Surgical-Lighting-MIT-2-75-2024/SurgicalLightBoostConverterModule/Rev A/SurgicalLightBoostConverterModuleBOM.xlsx

Id | Designator | Footprint | Quantity | Designation | Supplier and ref
1 | R15,R24,R19 | R_0805_2012Metric | 3 | 100K | RMCF0805FT100KCT-ND
2 | R16,R21,R3,R13,R12,R23 | R_0805_2012Metric | 6 | 1K | RMCF0805FT1K00CT-ND
3 | R9,R22,R25,R20,R10,R14 | R_0805_2012Metric | 6 | 10K | RMCF0805FT10K0CT-ND
4 | U1 | DIP-16_W7.62mm | 1 | TL494 | 296-10194-5-ND
5 | Q1,Q2,Q3 | TO-92_Inline | 3 | BC337 | BC337-25-APMSCT-ND
6 | TP6 | TestPoint_Loop_D2.54mm_Drill1.5mm_Beaded | 1 | 5V | 36-5260-ND
7 | R4,R5,R6 | R_0805_2012Metric | 3 | 10 | RMCF0805FT10R0CT-ND
8 | R8,R2 | R_0805_2012Metric | 2 | 2K | RNCP0805FTD2K00CT-ND
9 | C1,C2 | CP_Radial_D12.5mm_P5.00mm | 2 | 470uF | 1189-2329-ND
10 | TP13 | TestPoint_Loop_D2.54mm_Drill1.5mm_Beaded | 1 | CS- | 36-5264-ND
11 | C12,C7,C5,C6,C8,C10,C15,C9 | C_0805_2012Metric | 8 | 0.1uF | 1276-1003-1-ND
12 | R7 | R_0805_2012Metric | 1 | 330 | RMCF0805FT330RCT-ND
13 | C13 | C_0805_2012Metric | 1 | 1nF | 1276-1091-1-ND
14 | Q9,Q10,Q7,Q8 | TO-92_Inline | 4 | BC327 | BC32725BUFS-ND
15 | D3,D7,D4 | LED_0805_2012Metric | 3 | LED Green | 732-4983-1-ND
16 | J1 | PinHeader_2x07_P2.54mm_Vertical | 1 | 2x7 P2.54mm | 2057-PH2-14-UA-ND
17 | C11,C14 | C_0805_2012Metric | 2 | 1uF | 1276-1029-1-ND
18 | D5,D9,D2,D1,D6 | Nexperia_CFP15_SOT-1289 | 5 | PMEG045V150EPD | 1727-7635-1-ND
19 | L1 | L_Radial_D29.8mm_P29.30mm_Murata_1400series | 1 | 68uH 11.4A | M8376-ND
20 | Q4,Q5,Q6 | TO-220-3_Vertical | 3 | IRLZ44N | IRLZ44NPBF | or IRFZ44NPBF idk whatever ur getting dude
21 | TP1 | TestPoint_Loop_D2.54mm_Drill1.5mm_Beaded | 1 | LMount1 | N/A
22 | R17 | R_0805_2012Metric | 1 | 2K2 | RMCF0805FT2K20CT-ND
23 | U2 | DIP-8_W7.62mm_Socket | 1 | TL431D | 296-10182-5-ND
24 | TP12 | TestPoint_Loop_D2.54mm_Drill1.5mm_Beaded | 1 | 2IN- | 36-5269-ND
25 | TP8 | TestPoint_Loop_D2.54mm_Drill1.5mm_Beaded | 1 | 1IN+ | 36-5269-ND
26 | TP3 | TestPoint_Loop_D2.54mm_Drill1.5mm_Beaded | 1 | LMount4 | N/A
27 | C4,C3 | CP_Radial_D10.0mm_P5.00mm | 2 | 220uF | 1189-1759-ND
28 | TP2 | TestPoint_Loop_D2.54mm_Drill1.5mm_Beaded | 1 | LMount2 | N/A
29 | TP4 | TestPoint_Loop_D2.54mm_Drill1.5mm_Beaded | 1 | LMount3 | N/A
30 | D8 | LED_0805_2012Metric | 1 | LED Red | 732-4984-1-ND
31 | R11 | R_0805_2012Metric | 1 | 9.1K | 738-RMCF0805FT9K10CT-ND
32 | F1 | Fuseholder_Clip-6.3x32mm_Littelfuse_102071_Inline_P34.70x7.60mm_D2.00mm_Horizontal | 1 | 12A | 507-2231-ND
33 | R1 | R_2512_6332Metric | 1 | 5mR | CRF2512-FZ-R005ELFCT-ND
34 | TP5 | TestPoint_Loop_D2.54mm_Drill1.5mm_Beaded | 1 | 24V | 36-5260-ND
35 | TP10 | TestPoint_Loop_D2.54mm_Drill1.5mm_Beaded | 1 | DTC | 36-5269-ND
36 | TP7 | TestPoint_Loop_D2.54mm_Drill1.5mm_Beaded | 1 | 1IN- | 36-5269-ND
37 | TP11 | TestPoint_Loop_D2.54mm_Drill1.5mm_Beaded | 1 | CS+ | 36-5264-ND
38 | TP14 | TestPoint_Loop_D2.54mm_Drill1.5mm_Beaded | 1 | 2IN+ | 36-5269-ND
39 | U3 | DIP-8_W7.62mm_Socket | 1 | LM358 | 296-1395-5-ND
40 | TP9 | TestPoint_Loop_D2.54mm_Drill1.5mm_Beaded | 1 | PWM | 36-5269-ND
41 | R18 | R_0805_2012Metric | 1 | 3K9 | RMCF0805FT3K90CT-ND
42 | RV2,RV1 | PinHeader_1x03_P2.54mm_Vertical | 2 | 10K | 118-PV36W103C01B00-ND
