Surgical-Lighting-MIT-2-75-2024/SurgicalLightBoostConverterModule/Rev B/SurgicalLightBoostConverterModule.kicad_pcb

## KiCad design Rev B/SurgicalLightBoostConverterModule.kicad_pcb (2024-04-26)

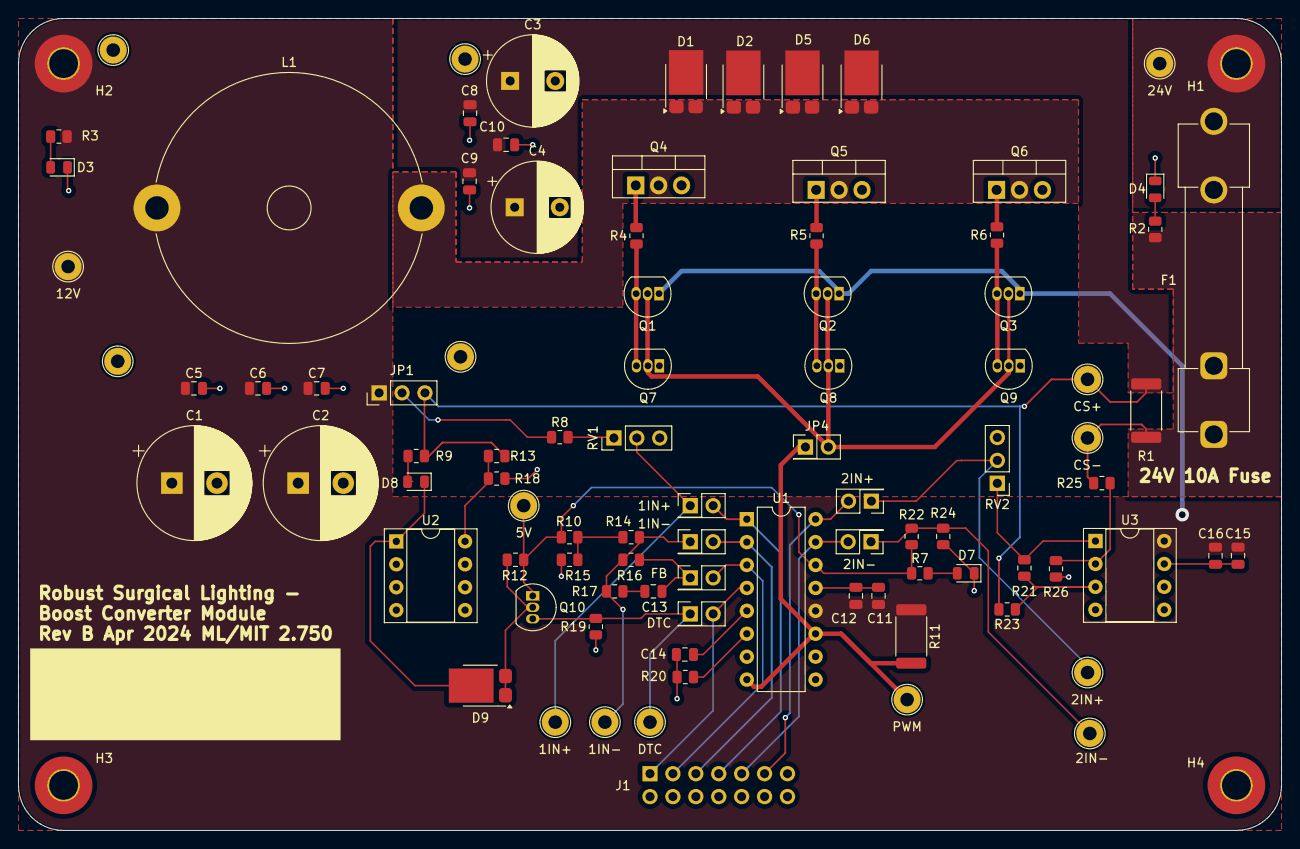
[picture p1: board Rev B/SurgicalLightBoostConverterModule.kicad_pcb from above]

Board: 2 copper layers, 140.0 x 90.0 mm, 96 parts (1 on the bottom side), 43 nets.

Parts:
1IN+: 1IN+; TestPoint_Loop_D2.54mm_Drill1.5mm_Beaded
1IN+#2: JMPR_1IN+; PinHeader_2x01_P2.54mm_Vertical
1IN-: 1IN-; TestPoint_Loop_D2.54mm_Drill1.5mm_Beaded
1IN-#2: JMPR_1IN-; PinHeader_2x01_P2.54mm_Vertical
2IN+: JMPR_2IN+; PinHeader_2x01_P2.54mm_Vertical
2IN+#2: 2IN+; TestPoint_Loop_D2.54mm_Drill1.5mm_Beaded
2IN-: 2IN-; TestPoint_Loop_D2.54mm_Drill1.5mm_Beaded
2IN-#2: JMPR_2IN-; PinHeader_2x01_P2.54mm_Vertical
5V: 5V; TestPoint_Loop_D2.54mm_Drill1.5mm_Beaded
12V: +12V; TestPoint_Loop_D2.54mm_Drill1.5mm_Beaded
24V: 24V; TestPoint_Loop_D2.54mm_Drill1.5mm_Beaded
C1, C2: 470uF; CP_Radial_D12.5mm_P5.00mm
C3, C4: 220uF; CP_Radial_D10.0mm_P5.00mm
C5, C6, C7, C8, C9, C10, C12, C13, C16: 0.1uF; C_0805_2012Metric
C11, C15: 1uF; C_0805_2012Metric
C14: 1nF; C_0805_2012Metric
CS+: CS+; TestPoint_Loop_D2.54mm_Drill1.5mm_Beaded
CS-: CS-; TestPoint_Loop_D2.54mm_Drill1.5mm_Beaded
D1, D2, D5, D6, D9: PMEG045V150EPD; Nexperia_CFP15_SOT-1289
D3, D4, D7: LED Green; LED_0805_2012Metric
D8: LED Red; LED_0805_2012Metric
DTC: JMPR_DTC; PinHeader_2x01_P2.54mm_Vertical
DTC#2: DTC; TestPoint_Loop_D2.54mm_Drill1.5mm_Beaded
F1: 12A; Fuseholder_Clip-6.3x32mm_Littelfuse_102071_Inline_P34.70x7.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
FB: JMPR_FB; PinHeader_2x01_P2.54mm_Vertical
H1, H2, H3, H4: M3 Hole; MountingHole_3.2mm_M3_Pad_TopBottom
J1: 2x7 P2.54mm; PinHeader_2x07_P2.54mm_Vertical
JP1: JMPR_VFB; PinHeader_1x03_P2.54mm_Vertical
JP4: JMPR_PWM; PinHeader_2x01_P2.54mm_Vertical
L1: 68uH 11.4A; L_Radial_D29.8mm_P29.30mm_Murata_1400series
PWM: PWM; TestPoint_Loop_D2.54mm_Drill1.5mm_Beaded
Q1, Q2, Q3: BC337; TO-92_Inline
Q4, Q5, Q6: AOT240L; TO-220-3_Vertical
Q7, Q8, Q9, Q10: BC327; TO-92_Inline
R1: 5mR; R_2512_6332Metric
R2: 4K7; R_0805_2012Metric
R3, R19: 2K2; R_0805_2012Metric
R4, R5, R6: 10; R_0805_2012Metric
R7: 330; R_0805_2012Metric
R8: 38K; R_0805_2012Metric
R9: 3K3; R_0805_2012Metric
R10, R12, R15, R22, R24: 10K; R_0805_2012Metric
R11: 100; R_2512_6332Metric
R13: 9.1K; R_0805_2012Metric
R14, R18, R23, R25: 1K; R_0805_2012Metric
R16, R21, R26: 100K; R_0805_2012Metric
R17: 82K; R_0805_2012Metric
R20: 3K9; R_0805_2012Metric
RV1, RV2: 10K; PinHeader_1x03_P2.54mm_Vertical
TP1: LMount1; TestPoint_Loop_D2.54mm_Drill1.5mm_Beaded
TP2: LMount2; TestPoint_Loop_D2.54mm_Drill1.5mm_Beaded
TP3: LMount4; TestPoint_Loop_D2.54mm_Drill1.5mm_Beaded
TP4: LMount3; TestPoint_Loop_D2.54mm_Drill1.5mm_Beaded
U1: TL494; DIP-16_W7.62mm
U2: TL431D; DIP-8_W7.62mm_Socket
U3: LM358; DIP-8_W7.62mm_Socket

Connections:
+5V: 5V.1, Q10.1 (C), R7.1, R10.1, R12.1, R22.1, U1.14 (REF)
+12V: 12V.1, C1.1, C2.1, C5.1, C6.1, C7.1, C11.1, C12.1, C15.1, C16.1, H2.1, JP1.1 (A), L1.1, Q1.1 (C), Q2.1 (C), Q3.1 (C), R3.1, R11.1, U1.12 (VCC), U3.8 (V+)
+24V: 24V.1, F1.2, H1.1
/1IN+: 1IN+#2.2 (B), J1.7, U1.1 (1IN+)
/1IN-: 1IN-#2.2 (B), J1.5, U1.2 (1IN-)
/2IN+: 2IN+.2 (B), J1.11, U1.16 (2IN+)
/2IN-: 2IN-#2.2 (B), J1.9, U1.15 (2IN-)
/CS+: C3.1, C4.1, C8.1, C9.1, C10.1, CS+.1, D1.3 (K), D2.3 (K), D5.3 (K), D6.3 (K), JP1.3 (B), R1.1, R9.1, R13.1, R23.2
/CS-: CS-.1, F1.1, R1.2, R2.1, R25.1
/DTC: DTC.2 (B), J1.1, U1.4 (DTC)
/FB: FB.2 (B), J1.3, U1.3 (FB)
/VSwitch: D1.1 (A), D1.2 (A), D2.1 (A), D2.2 (A), D5.1 (A), D5.2 (A), D6.1 (A), D6.2 (A), L1.2, Q4.2 (D), Q5.2 (D), Q6.2 (D)
GND: C1.2, C2.2, C3.2, C4.2, C5.2, C6.2, C7.2, C8.2, C9.2, C10.2, C11.2, C12.2, C14.2, C15.2, C16.2, D3.1 (K), D4.1 (K), D7.1 (K), H3.1, H4.1, J1.14, Q4.3 (S), Q5.3 (S), Q6.3 (S), Q7.1 (C), Q8.1 (C), Q9.1 (C), R15.2, R18.2, R19.2, R20.2, R24.2, R26.1, RV1.3, RV2.3, U1.7 (GND), U1.9 (E1), U1.10 (E2), U1.13 (OUTCTRL), U2.2 (A), U2.3 (A), U2.6 (A), U2.7 (A), U3.4 (V-), U3.5 (+), U3.6 (-), U3.7
unnamed: C13.1, R17.2
unnamed: D3.2 (A), R3.2
unnamed: D4.2 (A), R2.2
unnamed: D7.2 (A), R7.2
unnamed: D8.2 (A), R9.2
unnamed: D8.1 (K), D9.3 (K), U2.1 (K)
unnamed: JP1.2 (C), R8.1
unnamed: 1IN+.1, 1IN+#2.1 (A), RV1.2
unnamed: 1IN-.1, 1IN-#2.1 (A), R14.2, R16.1, R17.1
unnamed: JP4.1 (A), PWM.1, R11.2, U1.8 (C1), U1.11 (C2)
unnamed: C13.2, FB.1 (A), R16.2
unnamed: DTC.1 (A), DTC#2.1, Q10.3 (E), R19.1
unnamed: 2IN-.1, 2IN-#2.1 (A), R22.2, R24.1
unnamed: 2IN+.1 (A), 2IN+#2.1, RV2.2
unnamed: Q1.3 (E), Q7.3 (E), R4.1
unnamed: Q2.3 (E), Q8.3 (E), R5.1
unnamed: Q3.3 (E), Q9.3 (E), R6.1
unnamed: Q4.1 (G), R4.2
unnamed: Q5.1 (G), R5.2
unnamed: Q6.1 (G), R6.2
unnamed: D9.1 (A), D9.2 (A), Q10.2 (B), R12.2
unnamed: R8.2, RV1.1
unnamed: R10.2, R14.1, R15.1
unnamed: R21.1, RV2.1, U3.1
unnamed: C14.1, U1.5 (CT)
unnamed: R20.1, U1.6 (RT)
unnamed: R13.2, R18.1, U2.8 (REF)
unnamed: R21.2, R23.1, U3.3 (+)
unnamed: R25.2, R26.2, U3.2 (-)
PWM: JP4.2 (B), Q1.2 (B), Q2.2 (B), Q3.2 (B), Q7.2 (B), Q8.2 (B), Q9.2 (B)
