Surgical-Lighting-MIT-2-75-2024/SurgicalLightBoostConverterModule/Rev A/SurgicalLightBoostConverterModule.kicad_pcb

## KiCad design Rev A/SurgicalLightBoostConverterModule.kicad_pcb (2024-04-05, an earlier design)

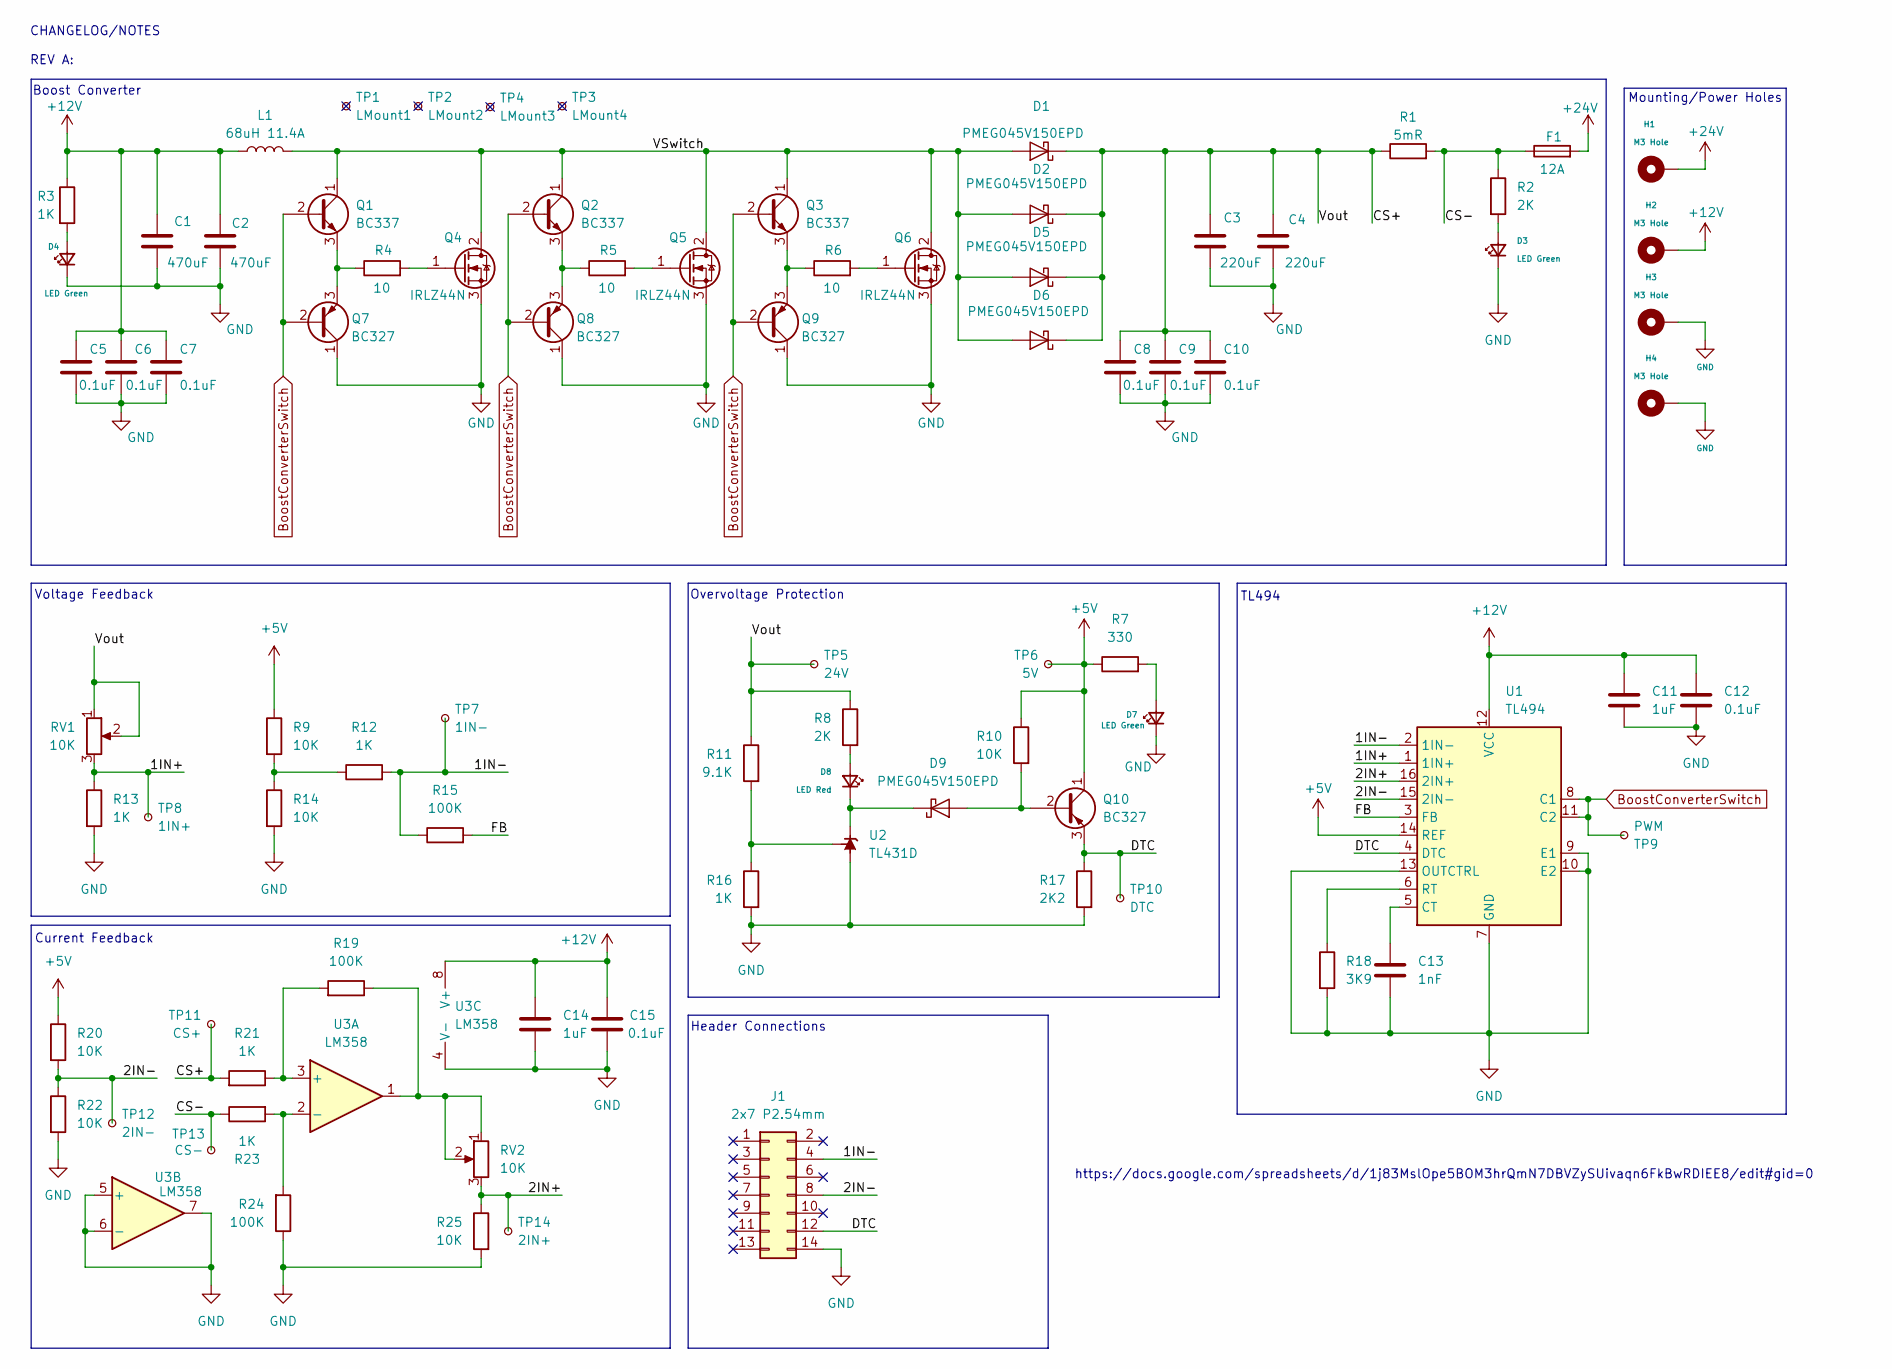
[picture p2: schematic SurgicalLightBoostConverterModule.kicad_sch, Main]

Parts:
C1, C2: 470uF; CP_Radial_D12.5mm_P5.00mm
C3, C4: 220uF; CP_Radial_D10.0mm_P5.00mm
C5, C6, C7, C8, C9, C10, C12, C15: 0.1uF; C_0805_2012Metric
C11, C14: 1uF; C_0805_2012Metric
C13: 1nF; C_0805_2012Metric
D1, D2, D5, D6, D9: PMEG045V150EPD; Nexperia_CFP15_SOT-1289
D3, D4, D7: LED Green; LED_0805_2012Metric
D8: LED Red; LED_0805_2012Metric
F1: 12A; Fuseholder_Clip-6.3x32mm_Littelfuse_102071_Inline_P34.70x7.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
H1, H2, H3, H4: M3 Hole; MountingHole_3.2mm_M3_Pad_TopBottom
J1: 2x7 P2.54mm; PinHeader_2x07_P2.54mm_Vertical
L1: 68uH 11.4A; L_Radial_D29.8mm_P29.30mm_Murata_1400series
Q1, Q2, Q3: BC337; TO-92_Inline
Q4, Q5, Q6: IRLZ44N; TO-220-3_Vertical
Q7, Q8, Q9, Q10: BC327; TO-92_Inline
R1: 5mR; R_2512_6332Metric
R2, R8: 2K; R_0805_2012Metric
R3, R12, R13, R16, R21, R23: 1K; R_0805_2012Metric
R4, R5, R6: 10; R_0805_2012Metric
R7: 330; R_0805_2012Metric
R9, R10, R14, R20, R22, R25: 10K; R_0805_2012Metric
R11: 9.1K; R_0805_2012Metric
R15, R19, R24: 100K; R_0805_2012Metric
R17: 2K2; R_0805_2012Metric
R18: 3K9; R_0805_2012Metric
RV1, RV2: 10K; PinHeader_1x03_P2.54mm_Vertical
TP1: LMount1; TestPoint_Loop_D2.54mm_Drill1.5mm_Beaded
TP2: LMount2; TestPoint_Loop_D2.54mm_Drill1.5mm_Beaded
TP3: LMount4; TestPoint_Loop_D2.54mm_Drill1.5mm_Beaded
TP4: LMount3; TestPoint_Loop_D2.54mm_Drill1.5mm_Beaded
TP5: 24V; TestPoint_Loop_D2.54mm_Drill1.5mm_Beaded
TP6: 5V; TestPoint_Loop_D2.54mm_Drill1.5mm_Beaded
TP7: 1IN-; TestPoint_Loop_D2.54mm_Drill1.5mm_Beaded
TP8: 1IN+; TestPoint_Loop_D2.54mm_Drill1.5mm_Beaded
TP9: PWM; TestPoint_Loop_D2.54mm_Drill1.5mm_Beaded
TP10: DTC; TestPoint_Loop_D2.54mm_Drill1.5mm_Beaded
TP11: CS+; TestPoint_Loop_D2.54mm_Drill1.5mm_Beaded
TP12: 2IN-; TestPoint_Loop_D2.54mm_Drill1.5mm_Beaded
TP13: CS-; TestPoint_Loop_D2.54mm_Drill1.5mm_Beaded
TP14: 2IN+; TestPoint_Loop_D2.54mm_Drill1.5mm_Beaded
U1: TL494; DIP-16_W7.62mm
U2: TL431D; DIP-8_W7.62mm_Socket
U3: LM358; DIP-8_W7.62mm_Socket

Connections:
+5V: Q10.1 (C), R7.1, R9.1, R10.1, R20.1, TP6.1, U1.14 (REF)
+12V: C1.1, C2.1, C5.1, C6.1, C7.1, C11.1, C12.1, C14.1, C15.1, H2.1, L1.1, R3.1, U1.12 (VCC), U3.8 (V+)
+24V: F1.2, H1.1
/1IN+: R13.1, RV1.3, TP8.1, U1.1 (1IN+)
/1IN-: J1.4, R12.2, R15.1, TP7.1, U1.2 (1IN-)
/2IN+: R25.1, RV2.3, TP14.1, U1.16 (2IN+)
/2IN-: J1.8, R20.2, R22.1, TP12.1, U1.15 (2IN-)
/CS+: C3.1, C4.1, C8.1, C9.1, C10.1, D1.3 (K), D2.3 (K), D5.3 (K), D6.3 (K), R1.1, R8.1, R11.1, R21.2, RV1.1, RV1.2, TP5.1, TP11.1
/CS-: F1.1, R1.2, R2.1, R23.1, TP13.1
/DTC: J1.12, Q10.3 (E), R17.1, TP10.1, U1.4 (DTC)
/FB: R15.2, U1.3 (FB)
/VSwitch: D1.1 (A), D1.2 (A), D2.1 (A), D2.2 (A), D5.1 (A), D5.2 (A), D6.1 (A), D6.2 (A), L1.2, Q1.1 (C), Q2.1 (C), Q3.1 (C), Q4.2 (D), Q5.2 (D), Q6.2 (D)
BoostConverterSwitch: Q1.2 (B), Q2.2 (B), Q3.2 (B), Q7.2 (B), Q8.2 (B), Q9.2 (B), TP9.1, U1.8 (C1), U1.11 (C2)
GND: C1.2, C2.2, C3.2, C4.2, C5.2, C6.2, C7.2, C8.2, C9.2, C10.2, C11.2, C12.2, C13.2, C14.2, C15.2, D3.1 (K), D4.1 (K), D7.1 (K), H3.1, H4.1, J1.14, Q4.3 (S), Q5.3 (S), Q6.3 (S), Q7.1 (C), Q8.1 (C), Q9.1 (C), R13.2, R14.2, R16.2, R17.2, R18.2, R22.2, R24.1, R25.2, U1.7 (GND), U1.9 (E1), U1.10 (E2), U1.13 (OUTCTRL), U2.2 (A), U2.3 (A), U2.6 (A), U2.7 (A), U3.4 (V-), U3.5 (+), U3.6 (-), U3.7
unnamed: D3.2 (A), R2.2
unnamed: D4.2 (A), R3.2
unnamed: D7.2 (A), R7.2
unnamed: D8.2 (A), R8.2
unnamed: D8.1 (K), D9.3 (K), U2.1 (K)
unnamed: Q1.3 (E), Q7.3 (E), R4.1
unnamed: Q2.3 (E), Q8.3 (E), R5.1
unnamed: Q3.3 (E), Q9.3 (E), R6.1
unnamed: Q4.1 (G), R4.2
unnamed: Q5.1 (G), R5.2
unnamed: Q6.1 (G), R6.2
unnamed: D9.1 (A), D9.2 (A), Q10.2 (B), R10.2
unnamed: R9.2, R12.1, R14.1
unnamed: R19.1, RV2.1, RV2.2, U3.1
unnamed: C13.1, U1.5 (CT)
unnamed: R18.1, U1.6 (RT)
unnamed: R11.2, R16.1, U2.8 (REF)
unnamed: R19.2, R21.1, U3.3 (+)
unnamed: R23.2, R24.2, U3.2 (-)

Notes on the sheet:
TL494
Boost Converter
https://docs.google.com/spreadsheets/d/1j83MslOpe5BOM3hrQmN7DBVZySUivaqn6FkBwRDIEE8/edit#gid=0
Voltage Feedback
Mounting/Power Holes
Overvoltage Protection
Current Feedback
Header Connections
CHANGELOG/NOTES REV A:

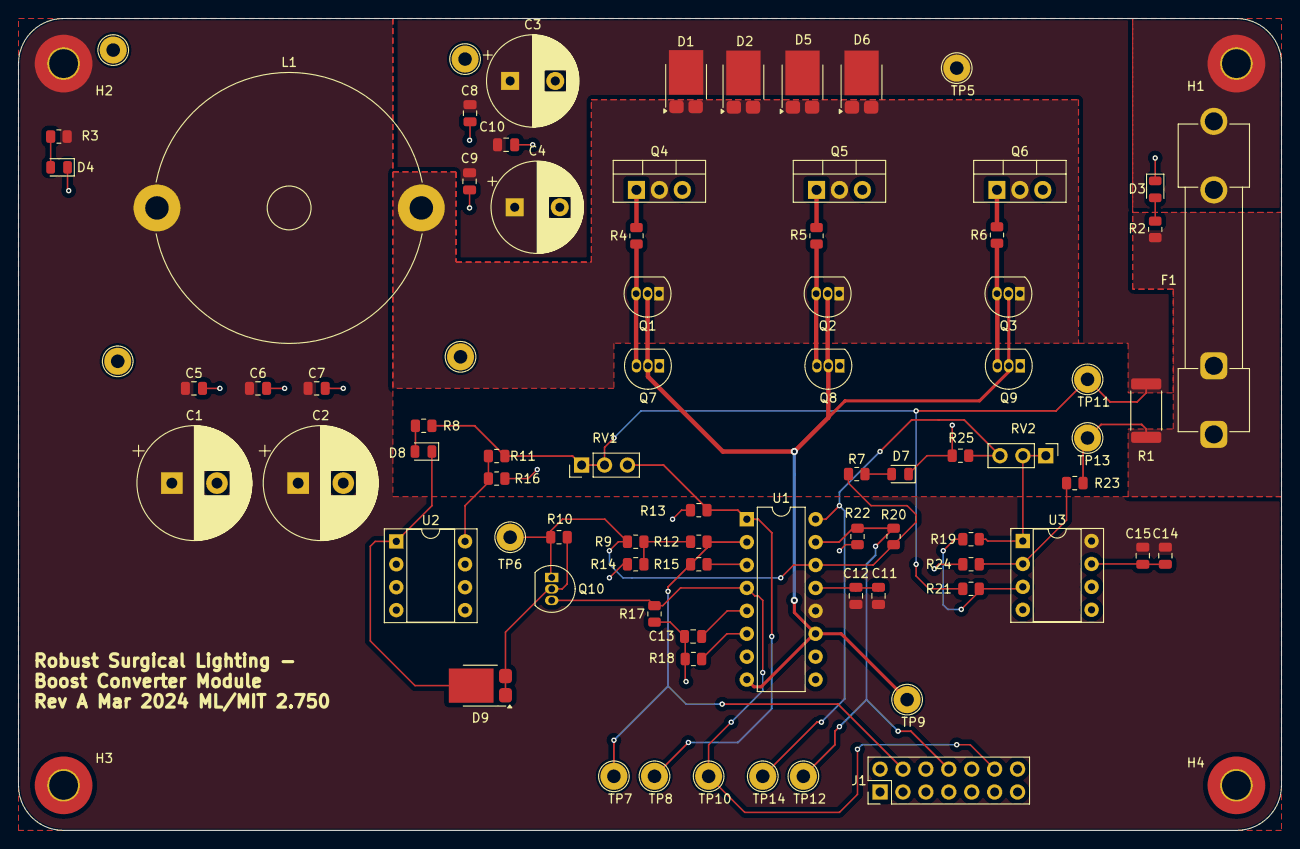
[picture p3: board Rev A/SurgicalLightBoostConverterModule.kicad_pcb from above]

Board: 2 copper layers, 140.0 x 90.0 mm, 85 parts (0 on the bottom side), 33 nets.
