Surgical-Lighting-MIT-2-75-2024/SurgicalLightBoostConverterModule/(commit log)

2024-03-30 First commit.
    [SurgicalLightBoostConverterModule.kicad_pcb, SurgicalLightBoostConverterModule.kicad_sch]
2024-03-30 Added boost converter.
    [SurgicalLightBoostConverterModule.kicad_sch]
2024-03-31 Added feedback and protection circuits.
    [SurgicalLightBoostConverterModule.kicad_sch]
2024-03-31 More schematic updates.
    [SurgicalLightBoostConverterModule.kicad_sch]
2024-04-01 PCB? :(
    [SurgicalLightBoostConverterModule.kicad_pcb, SurgicalLightBoostConverterModule.kicad_sch]
2024-04-04 added michael's changes
    [SurgicalLightBoostConverterModule.kicad_pcb, SurgicalLightBoostConverterModule.kicad_sch]
2024-04-25 Rev B!
    [SurgicalLightBoostConverterModule.kicad_pcb, SurgicalLightBoostConverterModule.kicad_sch]
2024-04-26 Silk screen.
    [SurgicalLightBoostConverterModule.kicad_pcb]
2024-04-26 Silk screenz.
    [SurgicalLightBoostConverterModule.kicad_sch]
2024-04-26 Updated text for testpoints and jumpers.
    [SurgicalLightBoostConverterModule.kicad_pcb]
